SophonSnwflake/rocket-docs/docs/structures/totalstructure/index.md

# 箭体结构

记录火箭整体机械结构各部件的三维模型（STEP 格式），涵盖箭体、头锥、尾翼、发动机舱、航电舱、伞舱以及各连接环等部件。

## 部件 3D 模型（用于2026-10-3发射）

以下为各结构部件的三维模型文件，点击文件名即可下载：

| 部件 | 模型文件 |
|---|---|
| 箭体 | [箭体.step](assets/箭体.step)、[箭体 v3.step](assets/箭体%20v3.step) |
| 头锥 | [头锥111.step](assets/头锥111.step) |
| 尾翼 | [尾翼.step](assets/尾翼.step) |
| 发动机舱 | [发动机舱.step](assets/发动机舱.step) |
| 航电舱 | [航电舱.step](assets/航电舱.step) |
| 伞舱 | [伞舱.step](assets/伞舱.step) |
| 连接环 | [连接环.step](assets/连接环.step) |
| 中心环 | [中心环.step](assets/中心环.step) |
| 连接环_带螺丝孔_缩小长度 | [连接环.SLDPRT](assets/连接环带螺丝孔.SLDPRT) |
| 连接环_带螺丝孔_缩小长度 | [连接环.stl](assets/连接环缩短带螺丝.STL) |

## 部件 3D 模型

[燃料中心棒固定环文件](FuelFixRing/index.md)

## 说明

* 模型采用 STEP 格式（ISO 10303），适用于主流三维 CAD 软件（如 SolidWorks、Fusion 360、FreeCAD 等）。
* 各部件模型将随设计迭代持续更新。
