SophonSnwflake/rocket-docs/docs/propulsion/index.md

<figure markdown>
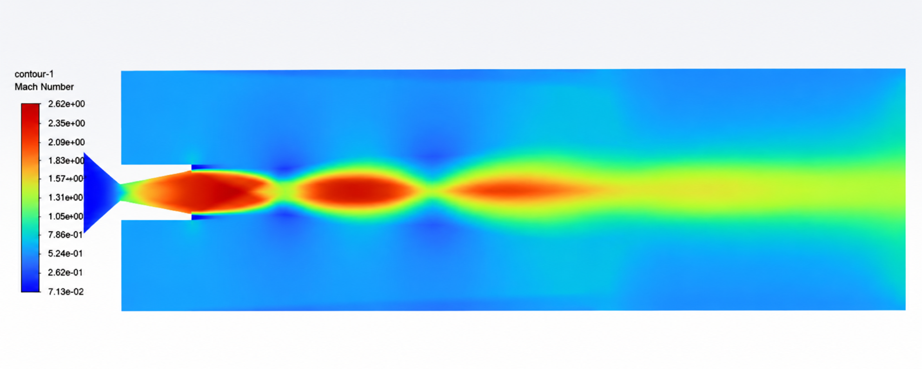
[picture p20: docs/propulsion/assets/picture/LOGO.png]
  
</figure>

# 推进系统

文档AI等级：4

推进系统是火箭产生推力并完成飞行任务的动力来源。

本板块用于记录火箭发动机设计、推进剂研究、发动机性能分析、静态测试、制造过程以及相关工程数据。

推进系统文档重点记录推进方案的设计依据、理论分析、实验数据以及实际工程经验，使后续开发人员能够理解发动机设计过程，而不仅仅获得最终参数。

---

## 系统概述

火箭推进系统主要负责：

- 产生满足飞行需求的推力
- 提供稳定可控的推力曲线
- 保证发动机结构安全
- 验证理论设计与实际性能之间的差异

推进系统通常由以下部分组成：

- 推进剂
- 燃烧室
- 喷管
- 点火系统
- 发动机壳体
- 保温与隔热结构
- 发动机与箭体连接结构

---

## 火箭燃料

固体火箭推进剂（燃料）的配方研究、制备工艺与性能测试相关资料。

| 板块 | 说明 | 文档 |
| -- | ---- | ---- |
| 火箭燃料 | 推进剂配方、原材料、制备工艺与测试资料 | [进入火箭燃料板块](fuel/index.md) |

---

## 发动机版本

| 版本 | 状态 | 简介 | 文档 |
| -- | ---- | ---- | ---- |
| V2 | 设计阶段 | 固体推进剂实验发动机，KNSB 推进剂，2026-07 开始设计 | [进入 V2 代发动机文档](v2/index.md) |

## 试车台

| 版本 | 状态 | 简介 | 文档 |
| -- | ---- | ---- | ---- |
| Oct 3 2026 | 正在使用 | 铝型材试车台，HX711, SD卡读取，串口控制 | [进入试车台文档](Oct_3_2026_TestMachine/index.md) |

> 上表中的版本状态应随着项目进展持续更新。

---
