SophonSnwflake/rocket-docs/docs/flight_records/index.md

# 飞行记录

飞行记录板块，用于记录火箭的实际飞行的相关文档

| 发射时间 | 飞控版本 | 简介 | 文档 |
| -- | ---- | ---- | ---- |
| Oct 3 2026 | V2.0 | 预计10.3发射于河南新乡 | [进入本次发射](Oct_3_2026/index.md) |
