SophonSnwflake/rocket-docs/docs/mad/index.md

<figure markdown>
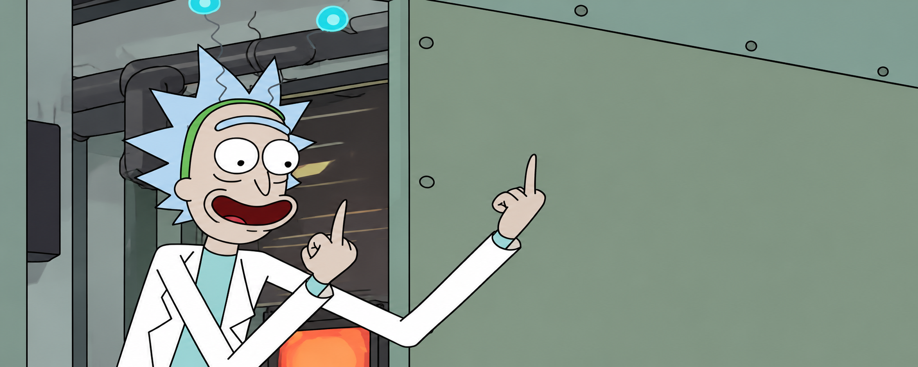
[picture p21: docs/mad/assets/picture/oldRick.png]
  
</figure>

# 发癫板块

本版块专门用于发癫、抽风和犯病，不设任何限制，可以说你任何想说的

### 8 Sep 2026 小叮当

没动力，不想推公式

### 14 Sep 2026 小叮当

我觉得工程和技术给人带来的应该是合作与共赢的文化，至少相较于零和竞争的商科是这样的。任何阻挠开放自由的环境并为此拉小圈子和小团体的人都是对开源文化的违背。

为何旧知己到最后变不成老友。

### 19 Sep 2026 小叮当

我觉得好累啊，这学期要做好多事，要完善航电，加新功能，期末均分要冲90，要参加科研进组，还要准备雅思。我觉得有点力不从心
