SophonSnwflake/rocket-docs/docs/development/index.md

# 开发规范（Development）

本区块用于记录一些团队开发过程中的开发规范文档

---

#### 文档工作流：[docsWorkflow](assets/docs_workflow.md)

#### 文档开发规范：[docsStandard](assets/docs_standard.md)
