SophonSnwflake/rocket-docs/docs/structures/avionics_bay/index.md

# 航电仓

| 版本 | 状态 | 简介 | 文档 |
| -- | ---- | --- | --- |
| V1 | 古早历史版本 | 2024年暑假搞的版本，适配性很差 | 无|
| V2 | 当前版本 | 当前主要开发与测试版本, 用于适配V2版本航电 | [进入 V2 文档](v2/index.md) |
