SophonSnwflake/rocket-docs/docs/avionics/v2/assets/hardware/BOM.xlsx

No. | Quantity | Comment | Designator | Footprint | Value | Manufacturer Part | Manufacturer | Supplier Part | Supplier
1 | 1 | 1uF | 1uF | C0603 | 1uF | CL10A105KO8NNNC | SAMSUNG(三星) | C1592 | LCSC
2 | 3 | 1.5kΩ | 1.5kΩ,1.5kΩ,1.5kΩ | R0603 | 1.5kΩ | FRC0603F1501TS | FOJAN(富捷) | C2930050 | LCSC
3 | 1 | 2.2uF | 2.2u | C0603 | 2.2uF | CL10A225KO8NNNC | SAMSUNG(三星) | C23630 | LCSC
4 | 1 | SI2301CDS-T1-GE3 | 3JG | SOT-23-3_L3.0-W1.7-P0.95-LS2.9-BR |  | SI2301CDS-T1-GE3 | VISHAY(威世) | C10487 | LCSC
5 | 2 | 4.7kΩ | 4.7k,4.7k | R0603 | 4.7kΩ | RCA034K7FLF | HKR(香港电阻) | C22369814 | LCSC
6 | 1 | 1kΩ | 10k | R0603 | 1kΩ | FRC0603F1001TS | FOJAN(富捷) | C2907002 | LCSC
7 | 10 | 10kΩ | 10k,10k,10k,10k,10k,10k,10k,10k,10kΩ,10kΩ | R0603 | 10kΩ | FRC0603F1002TS | FOJAN(富捷) | C2906982 | LCSC
8 | 1 | 10uF | 10u | C0603 | 10uF | HGC0603R5106M350NTHJ | Chinocera(华瓷) | C22367827 | LCSC
9 | 1 | 10uF | 10u | C0603 | 10uF | HGC0603R5106M160NTHJ | Chinocera(华瓷) | C7472959 | LCSC
10 | 2 | 10uF | 10u,10u | C0603 | 10uF | HGC0603R5106M250NTHJ | Chinocera(华瓷) | C7472961 | LCSC
11 | 2 | 16pF | 16pf,cristal_in | C0603 | 16pF | CC0603JRNPO9BN160 | YAGEO(国巨) | C327125 | LCSC
12 | 2 | 100kΩ | 100kΩ,100kΩ | R0603 | 100kΩ | FRC0603F1003TS | FOJAN(富捷) | C2906980 | LCSC
13 | 15 | 100nF | 100n,100n,100n,100n,100n,100n,100n,100n,100n,100n,100nF,100nf,VDD_1,VDD_2,VDD_3 | C0603 | 100nF | CL10B104KB8NNNC | SAMSUNG(三星) | C1591 | LCSC
14 | 2 | BLM18AG102SN1D | 500mΩ,imu_l | L0603 |  | BLM18AG102SN1D | muRata(村田) | C85824 | LCSC
15 | 2 | GH1.25mm-2P-LT | Battery,电子火柴 | CONN-SMD_2P-P1.25_THD1253-02WV-SN |  | GH1.25mm-2P-LT | LXWCONN(连兴旺电子) | C53055371 | LCSC
16 | 1 | BMI088 | BMI088 | LGA-16_L4.5-W3.0-P0.50-BL |  | BMI088 | Bosch(博世) | C194919 | LCSC
17 | 1 | BMP388 | BMP388 | SENSORM-SMD_BMP388 |  | BMP388 | Bosch(博世) | C779278 | LCSC
18 | 1 | 2.54-1*2 | BOOT | HDR-TH_2P-P2.54-V-M |  | 2.54-1*2 | ZHOURI(洲日) | C5116481 | LCSC
19 | 1 | 2.7kHz | BUZZER1 | BUZ-TH_BD12.0-P7.60-D0.6-FD | 2.7kHz | HMB1275-05B | 华能 | C96491 | LCSC
20 | 1 | S8050 | buzzer3jg | SOT-23-3_L2.9-W1.3-P1.90-LS2.3-BR |  | S8050 | R+O(宏嘉诚) | C20069125 | LCSC
21 | 1 | 100uF | C10 | C1206 | 100uF | HGC1206R5107M100NSPJ | Chinocera(华瓷) | C7432784 | LCSC
22 | 1 | W25Q128JVSIQ | Flash | SOIC-8_L5.3-W5.3-P1.27-LS8.0-BL |  | W25Q128JVSIQ | Winbond(华邦) | C97521 | LCSC
23 | 1 | WAFER-GH1.25-4PLB | GPS | CONN-SMD_4P-P1.25_XUNPU_WAFER-GH1.25-4PLB |  | WAFER-GH1.25-4PLB | XUNPU(讯普) | C3029370 | LCSC
24 | 2 | HX PZ2.54-1x4P ZZ | I2C,UART | HDR-TH_4P-P2.54-V-M |  | HX PZ2.54-1x4P ZZ | hanxia(韩下) | C32713270 | LCSC
25 | 1 | AO3400 | mos | SOT-23-3_L2.9-W1.3-P1.90-LS2.4-BR |  | AO3400 | Hottech(合科泰) | C181090 | LCSC
26 | 1 | 2.54-1*3P针 | PIN | HDR-TH_3P-P2.54-V-M-1 |  | 2.54-1*3P针 | BOOMELE(博穆精密) | C49257 | LCSC
27 | 1 | ME6217C33M5G | POWER | SOT-23-5_L3.0-W1.7-P0.95-LS2.8-BR |  | ME6217C33M5G | MICRONE(南京微盟) | C427602 | LCSC
28 | 1 | 6GHz | RF1 | SMA-TH_BWSMA-KE-Z001 | 6GHz | BWSMA-KE-Z001 | BAT WIRELESS(蝙蝠无线) | C496549 | LCSC
29 | 1 | PH2.54-1X5P-H25 | SWDIO | HDR-TH_5P-P2.54-V-M-3 |  | PH2.54-1X5P-H25 | JXTCONN(聚兴泰) | C42431835 | LCSC
30 | 1 | STM32F411CEU6TR | U2 | UFQFPN-48_L7.0-W7.0-P0.50-BL-EP5.6 |  | STM32F411CEU6TR | ST(意法半导体) | C2054095 | LCSC
31 | 1 | E22-400M22S | U7 | WIRELM-SMD_E22-400M22S |  | E22-400M22S | EBYTE(亿佰特) | C411291 | LCSC
32 | 1 | 25MHz | X1 | CRYSTAL-SMD_4P-L3.2-W2.5-BL | 25MHz | X322525MOB4SI | YXC(扬兴晶振) | C9006 | LCSC
33 | 1 | NCD0805Y1 | 危险状态指示 | LED0805-R-RD |  | NCD0805Y1 | 国星光电 | C84261 | LCSC
34 | 2 | PZ254V-11-02P | 点火安全保护,电源开关 | HDR-TH_2P-P2.54-V-M |  | PZ254V-11-02P | XFCN(兴飞) | C492401 | LCSC
35 | 1 | NCD0805R1 | 红 | LED0805-RD |  | NCD0805R1 | 国星光电 | C84256 | LCSC
36 | 1 | XL-2012UBC | 蓝 | LED0805-RD |  | XL-2012UBC | XINGLIGHT(成兴光) | C965817 | LCSC
