SophonSnwflake/rocket-docs/docs/propulsion/v2/assets/model/堵头.step

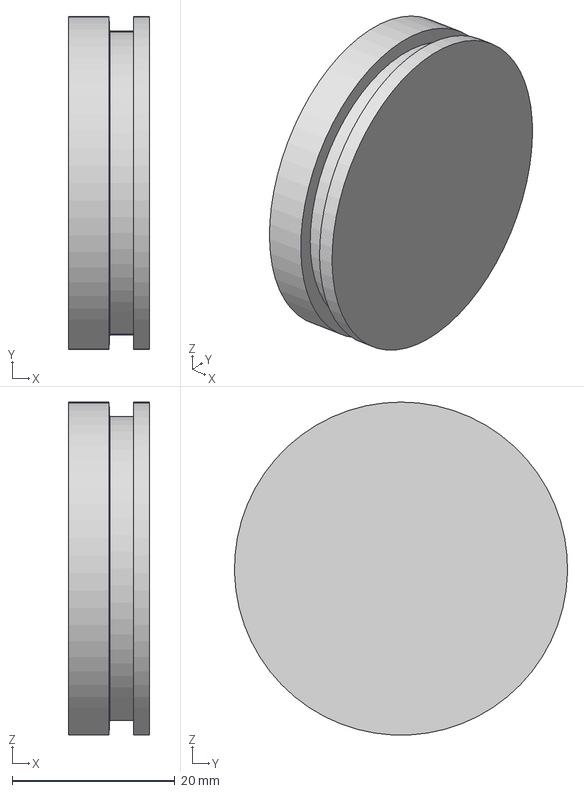
[picture p31: CAD file, 2026-08-23]
docs/propulsion/v2/assets/model/堵头.step
10.0 x 41.0 x 41.0 mm
