SophonSnwflake/rocket-docs/docs/structures/totalstructure/assets/连接环带螺丝孔.SLDPRT

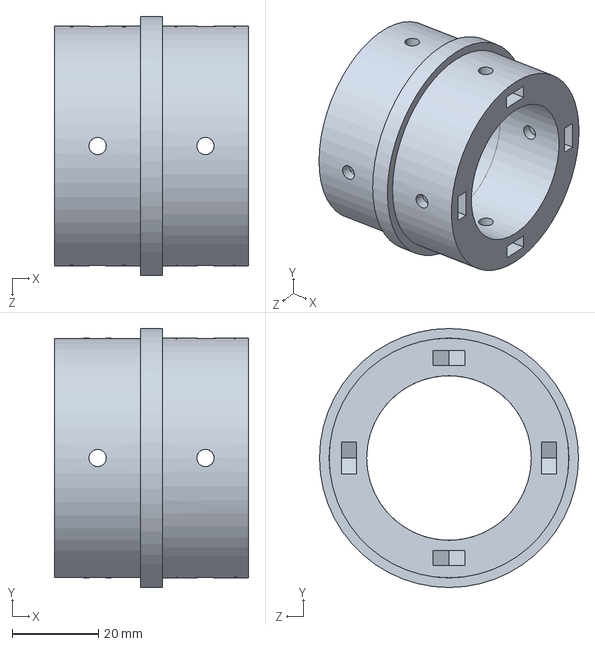
[picture p32: CAD file, 2026-09-23]
docs/structures/totalstructure/assets/连接环带螺丝孔.SLDPRT
45.0 x 60.0 x 60.0 mm
