SophonSnwflake/rocket-docs/docs/structures/totalstructure/FuelFixRing/assets/14mm.STL

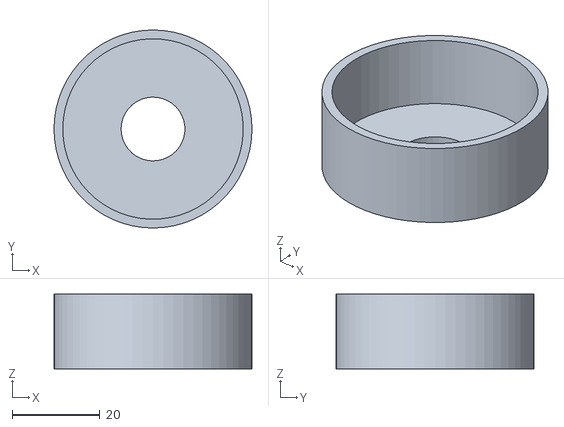
[picture p33: CAD file, 2026-09-30]
docs/structures/totalstructure/FuelFixRing/assets/14mm.STL
45.0 x 45.0 x 17.0
