SophonSnwflake/rocket-docs/docs/propulsion/v2/assets/model/喷口.step

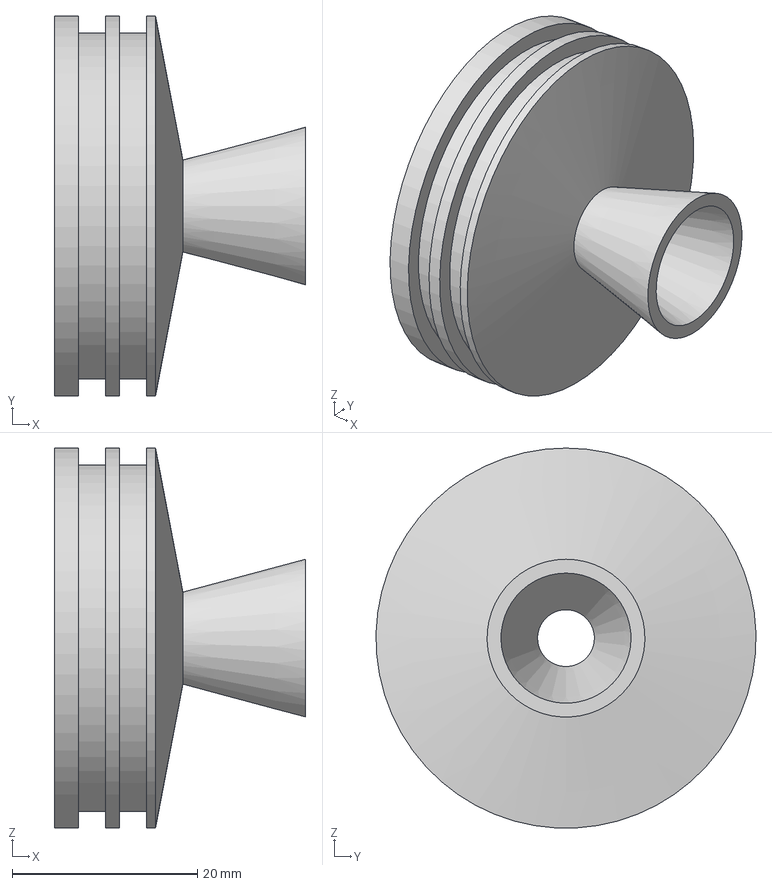
[picture p34: CAD file, 2026-08-23]
docs/propulsion/v2/assets/model/喷口.step
27.1 x 41.0 x 41.0 mm
