SophonSnwflake/rocket-docs/docs/structures/totalstructure/FuelFixRing/assets/22.STL

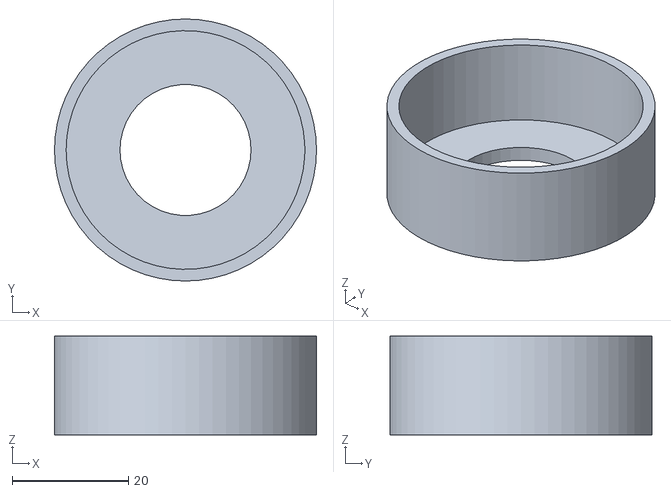
[picture p35: CAD file, 2026-09-30]
docs/structures/totalstructure/FuelFixRing/assets/22.STL
45.0 x 45.0 x 17.0
