SophonSnwflake/rocket-docs/docs/structures/totalstructure/assets/中心环.step

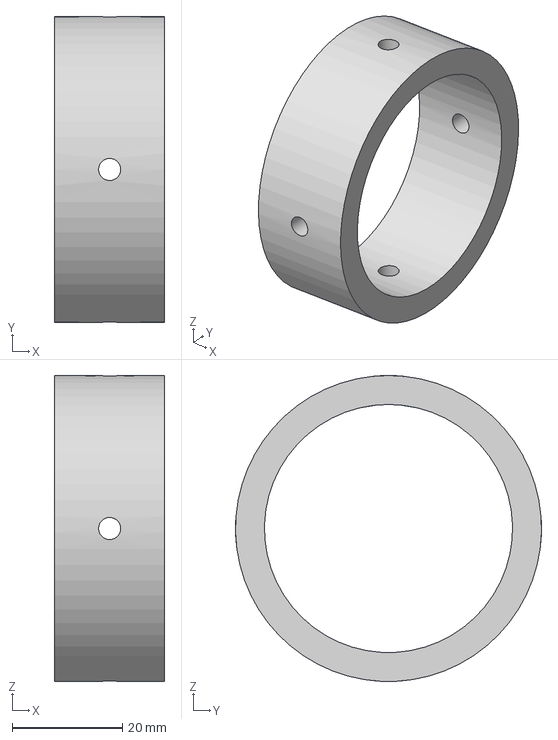
[picture p36: CAD file, 2026-08-23]
docs/structures/totalstructure/assets/中心环.step
20.0 x 55.5 x 55.5 mm
