SophonSnwflake/rocket-docs/docs/structures/totalstructure/FuelFixRing/assets/20mm.STL

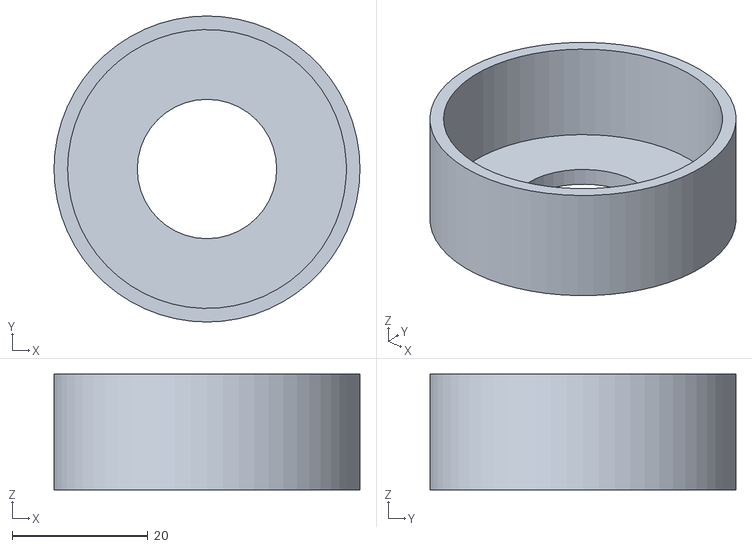
[picture p37: CAD file, 2026-09-30]
docs/structures/totalstructure/FuelFixRing/assets/20mm.STL
45.0 x 45.0 x 17.0
