SophonSnwflake/rocket-docs/docs/structures/totalstructure/assets/尾翼.step

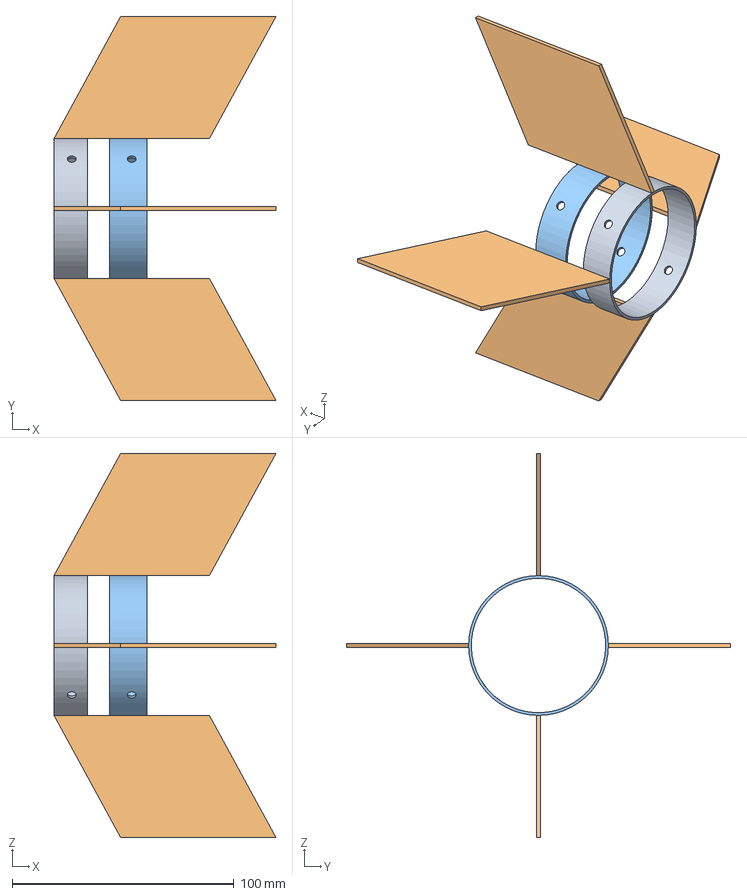
[picture p38: CAD file, 2026-08-23]
docs/structures/totalstructure/assets/尾翼.step
100.0 x 173.0 x 173.0 mm
