SophonSnwflake/rocket-docs/docs/structures/totalstructure/assets/伞舱.step

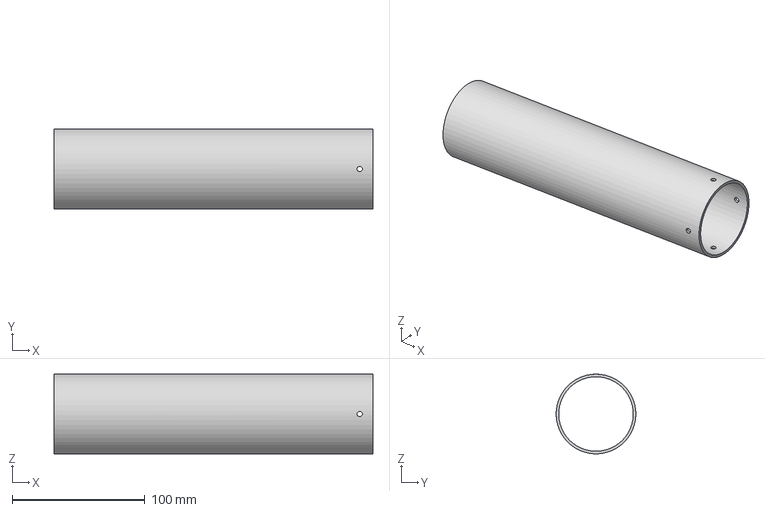
[picture p40: CAD file, 2026-08-23]
docs/structures/totalstructure/assets/伞舱.step
240.0 x 60.0 x 60.0 mm
