SophonSnwflake/rocket-docs/docs/structures/totalstructure/assets/箭体.step

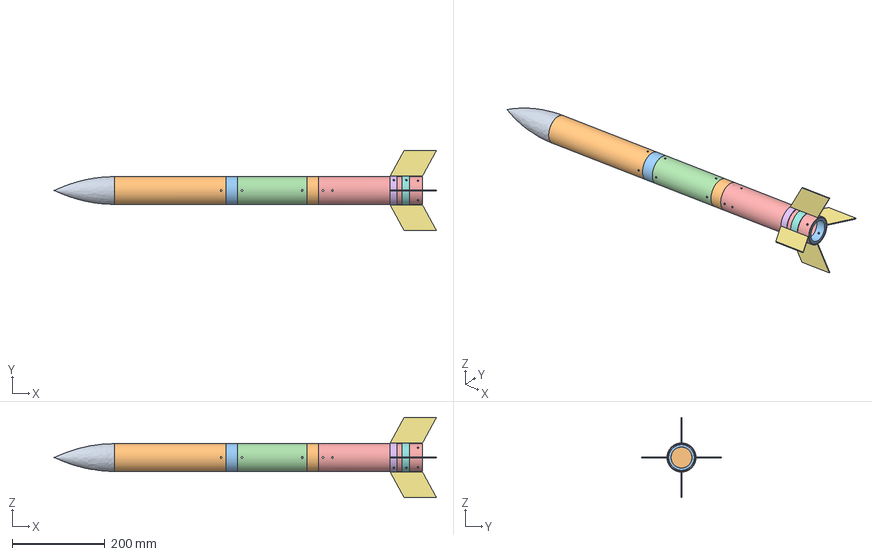
[picture p41: CAD file, 2026-08-23]
docs/structures/totalstructure/assets/箭体.step
825.0 x 173.0 x 173.0 mm
零部件1
零部件2
零部件3
零部件4
零部件5
零部件6
零部件7
