SophonSnwflake/rocket-docs/docs/structures/totalstructure/assets/发动机舱.step

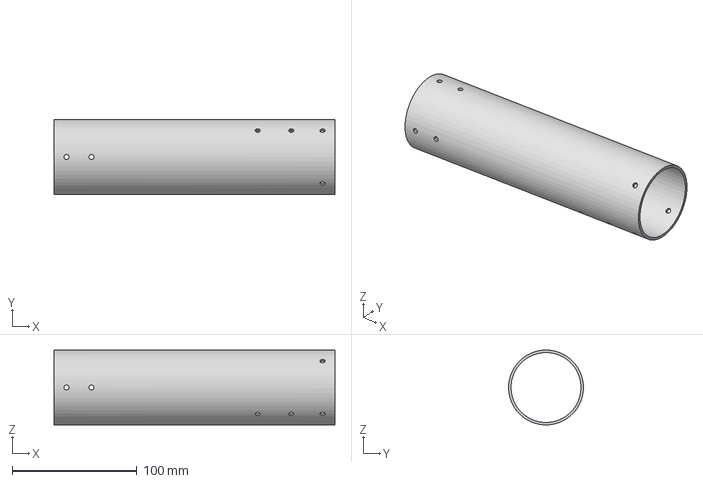
[picture p42: CAD file, 2026-08-23]
docs/structures/totalstructure/assets/发动机舱.step
225.0 x 60.0 x 60.0 mm
