SophonSnwflake/rocket-docs/docs/structures/totalstructure/assets/连接环.step

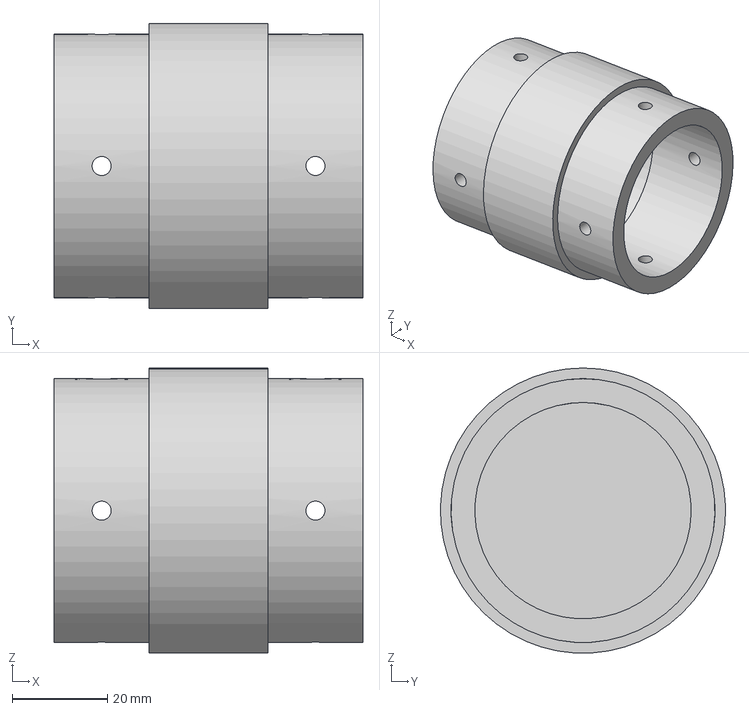
[picture p43: CAD file, 2026-08-23]
docs/structures/totalstructure/assets/连接环.step
65.0 x 60.0 x 59.9 mm
