SophonSnwflake/rocket-docs/docs/structures/totalstructure/assets/头锥111.step

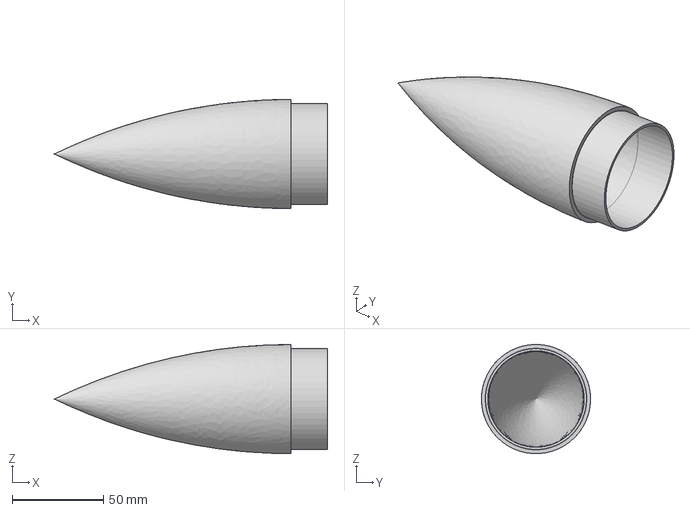
[picture p44: CAD file, 2026-08-23]
docs/structures/totalstructure/assets/头锥111.step
150.0 x 60.0 x 59.9 mm
