SophonSnwflake/rocket-docs/docs/structures/totalstructure/assets/航电舱.step

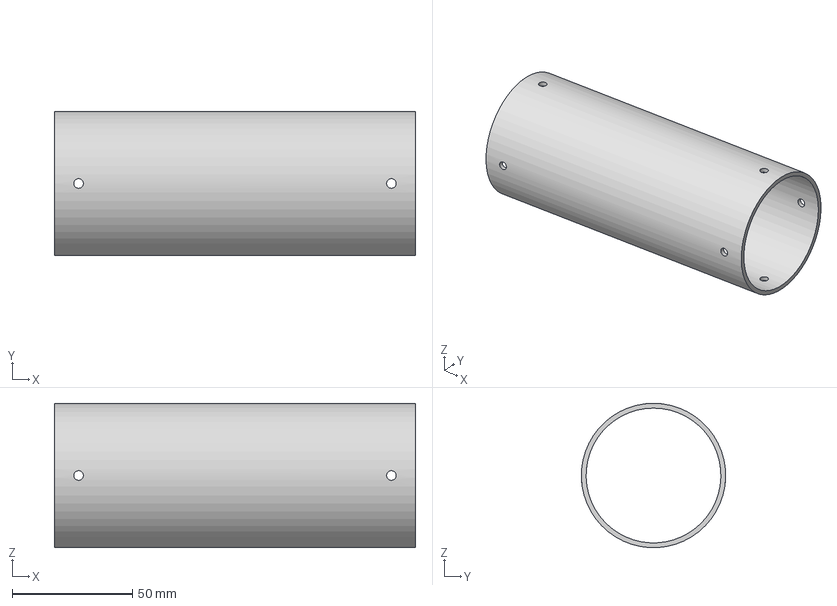
[picture p45: CAD file, 2026-08-23]
docs/structures/totalstructure/assets/航电舱.step
150.0 x 60.0 x 60.0 mm
