SophonSnwflake/rocket-docs/(list of files, cad)

Other CAD files:
docs/structures/totalstructure/assets/连接环缩短带螺丝.STL
docs/structures/totalstructure/assets/箭体 v3.step
