SophonSnwflake/rocket-docs/docs/propulsion/Oct_3_2026_TestMachine/index.md

# Oct_3_2026 试车台

本次试车台用于试验在2026年10月3日河南新乡所用火箭的发动机。

## 设计者：白

## 硬件设计：

- Arduino uno
- HX711-UART模块
- SD卡槽-UART模块
- 串口通信

## 软件版本（arduino）

| 序列 | 简介 | 源码 |
| -- | ---- | ---- |
| 1.2 | 10.1日试车采用的版本，遇到SD卡失联后会中断 | [下载源码](assets/thrust_capture_80hz_1.2.ino) |
| 1.3 | 更新了串口输出完整时间戳和推力数据，并且不会随着SD卡的失联而断掉串口 | [下载源码](assets//thrust_capture_80hz_1.3.ino) |
