SophonSnwflake/rocket-docs/docs/structures/totalstructure/FuelFixRing/index.md

### 燃料固定环3D模型

| 部件 | 模型文件 |
|---|---|
| 1 | [14mm.STL](assets/14mm.STL)|
| 2 | [20mm.STL](assets/20mm.STL) |
| 3 | [22mm.STL](assets/22.STL) |
| 4 | [25mm.STL](assets/25mm.STL) |
