SophonSnwflake/rocket-docs/docs/avionics/v2/assets/hardware/PCB图.pdf

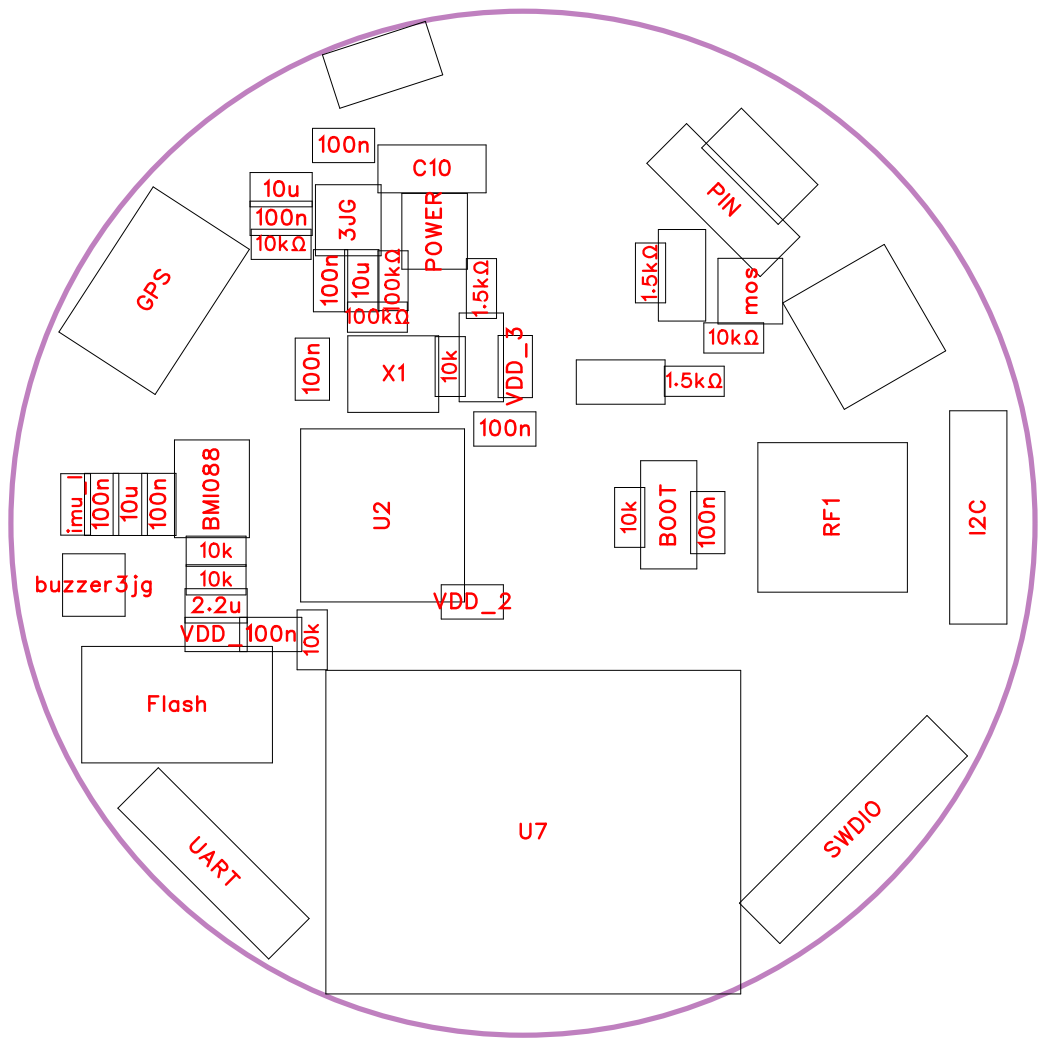
[picture p46: page 1]

VDD_1 | 100n

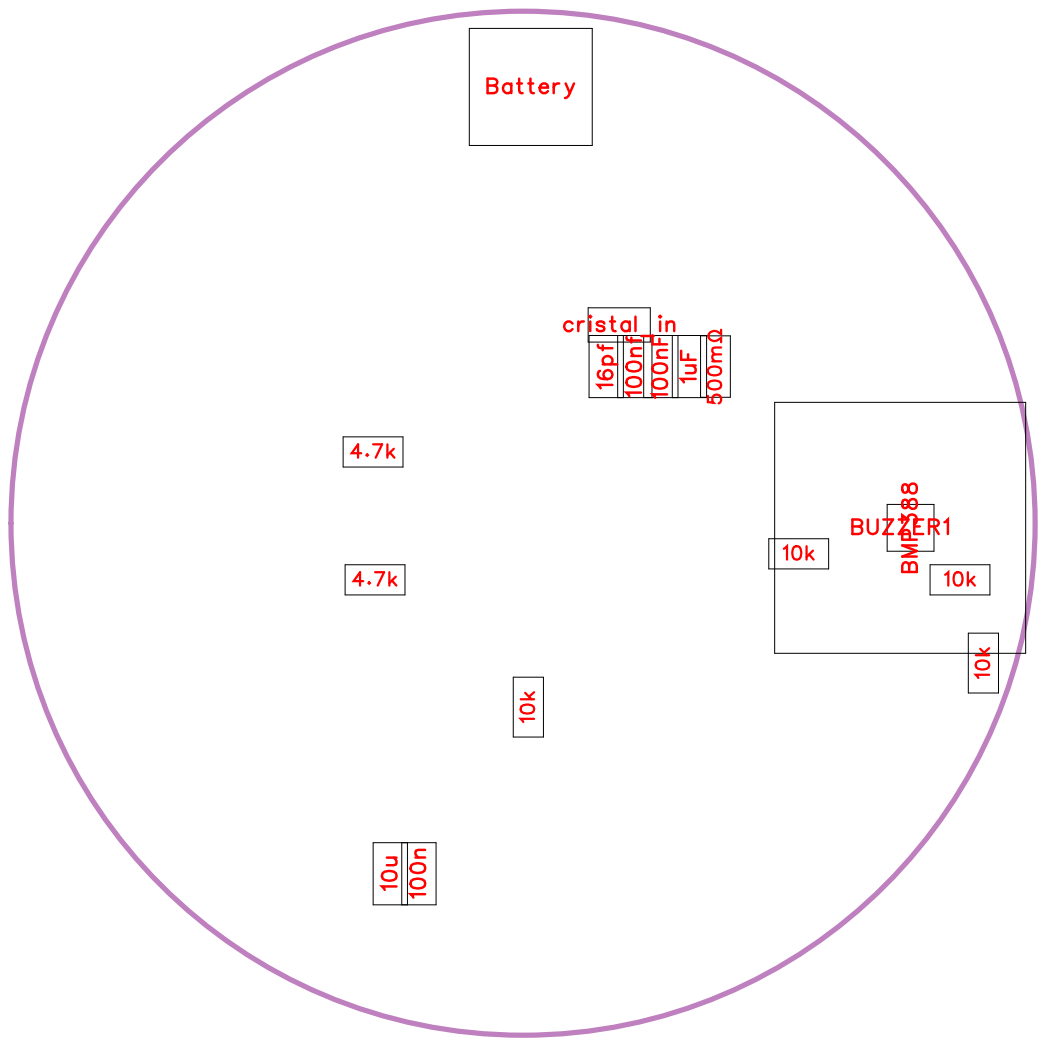
[picture p47: page 2]

No. | Quantity | Comment | Designator | Footprint | Value | Manufacturer Part | Manufacturer | Supplier Part | Supplier
1 | 1 | 1uF | 1uF | C0603 | 1uF | CL10A105K O8NNNC | SAMSUNG( 三星) | C1592 | LCSC
2 | 3 | 1.5k | 1.5k ,1.5k ,1.5k | R0603 | 1.5k | FRC0603F15 01TS | FOJAN(富捷) | C2930050 | LCSC
3 | 1 | 2.2uF | 2.2u | C0603 | 2.2uF | CL10A225K O8NNNC | SAMSUNG( 三星) | C23630 | LCSC
4 | 1 | SI2301CDS-T1-GE3 | 3JG | SOT-23-3_L3 .0-W1.7-P0.9 5-LS2.9-BR | | SI2301CDS-T1-GE3 | VISHAY(威世 ) | C10487 | LCSC
5 | 2 | 4.7k | 4.7k,4.7k | R0603 | 4.7k | RCA034K7F LF | HKR(香港电 阻) | C22369814 | LCSC
6 | 1 | 1k | 10k | R0603 | 1k | FRC0603F10 01TS | FOJAN(富捷) | C2907002 | LCSC
7 | 10 | 10k | 10k,10k,10k,10k,10k,10k,10 k,10k,10k ,10k | R0603 | 10k | FRC0603F10 02TS | FOJAN(富捷) | C2906982 | LCSC
8 | 1 | 10uF | 10u | C0603 | 10uF | HGC0603R5 106M350NT HJ | Chinocera(华 瓷) | C22367827 | LCSC
9 | 1 | 10uF | 10u | C0603 | 10uF | HGC0603R5 106M160NT HJ | Chinocera(华 瓷) | C7472959 | LCSC
10 | 2 | 10uF | 10u,10u | C0603 | 10uF | HGC0603R5 106M250NT HJ | Chinocera(华 瓷) | C7472961 | LCSC
11 | 2 | 16pF | 16pf,cristal_in | C0603 | 16pF | CC0603JRN PO9BN160 | YAGEO(国巨 ) | C327125 | LCSC
12 | 2 | 100k | 100k ,100k | R0603 | 100k | FRC0603F10 03TS | FOJAN(富捷) | C2906980 | LCSC
13 | 15 | 100nF | 100n,100n,100n,100n,100n, 100n,100n,100n,100n,100n, 100nF,100nf,VDD_1,VDD_2 ,VDD_3 | C0603 | 100nF | CL10B104KB 8NNNC | SAMSUNG( 三星) | C1591 | LCSC
14 | 2 | BLM18AG10 2SN1D | 500m ,imu_l | L0603 | | BLM18AG10 2SN1D | muRata(村田 ) | C85824 | LCSC
15 | 2 | GH1.25mm-2 P-LT | Battery,电子火柴 | CONN-SMD_ 2P-P1.25_TH D1253-02WV -SN | | GH1.25mm-2 P-LT | LXWCONN( 连兴旺电子) | C53055371 | LCSC
16 | 1 | BMI088 | BMI088 | LGA-16_L4.5 -W3.0-P0.50-BL | | BMI088 | Bosch(博世) | C194919 | LCSC
17 | 1 | BMP388 | BMP388 | SENSORM-S MD_BMP388 | | BMP388 | Bosch(博世) | C779278 | LCSC
18 | 1 | 2.54-1*2 | BOOT | HDR-TH_2P-P2.54-V-M | | 2.54-1*2 | ZHOURI(洲 日) | C5116481 | LCSC
19 | 1 | 2.7kHz | BUZZER1 | BUZ-TH_BD 12.0-P7.60-D 0.6-FD | 2.7kHz | HMB1275-05 B | 华能 | C96491 | LCSC

20 | 1 | S8050 | buzzer3jg | SOT-23-3_L2 .9-W1.3-P1.9 0-LS2.3-BR | | S8050 | R+O(宏嘉诚 ) | C20069125 | LCSC
21 | 1 | 100uF | C10 | C1206 | 100uF | HGC1206R5 107M100NS PJ | Chinocera( 华 瓷 ) | C7432784 | LCSC
22 | 1 | W25Q128JV SIQ | Flash | SOIC-8_L5.3 -W5.3-P1.27-LS8.0-BL | | W25Q128JV SIQ | Winbond( 华 ) 邦 | C97521 | LCSC
23 | 1 | WAFER-GH1 .25-4PLB | GPS | CONN-SMD_ 4P-P1.25_X UNPU_WAF ER-GH1.25-4 PLB | | WAFER-GH1 .25-4PLB | XUNPU(讯普 ) | C3029370 | LCSC
24 | 2 | HX PZ2.54-1x4P ZZ | I2C,UART | HDR-TH_4P-P2.54-V-M | | HX PZ2.54-1x4P ZZ | hanxia(韩下 ) | C32713270 | LCSC
25 | 1 | AO3400 | mos | SOT-23-3_L2 .9-W1.3-P1.9 0-LS2.4-BR | | AO3400 | Hottech(合科 泰) | C181090 | LCSC
26 | 1 | 2.54-1*3P 针 | PIN | HDR-TH_3P-P2.54-V-M-1 | | 2.54-1*3P 针 | BOOMELE( ) 博穆精密 | C49257 | LCSC
27 | 1 | ME6217C33 M5G | POWER | SOT-23-5_L3 .0-W1.7-P0.9 5-LS2.8-BR | | ME6217C33 M5G | MICRONE( 南 ) 京微盟 | C427602 | LCSC
28 | 1 | 6GHz | RF1 | SMA-TH_BW SMA-KE-Z00 1 | 6GHz | BWSMA-KE-Z001 | BAT WIRELE SS(蝙蝠无线 ) | C496549 | LCSC
29 | 1 | PH2.54-1X5 P-H25 | SWDIO | HDR-TH_5P-P2.54-V-M-3 | | PH2.54-1X5 P-H25 | JXTCONN( 聚 兴泰 ) | C42431835 | LCSC
30 | 1 | STM32F411 CEU6TR | U2 | UFQFPN-48 _L7.0-W7.0-P0.50-BL-EP 5.6 | | STM32F411 CEU6TR | ST(意法半导 体) | C2054095 | LCSC
31 | 1 | E22-400M22 S | U7 | WIRELM-SM D_E22-400M 22S | | E22-400M22 S | EBYTE(亿佰 特) | C411291 | LCSC
32 | 1 | 25MHz | X1 | CRYSTAL-S MD_4P-L3.2-W2.5-BL | 25MHz | X322525MO B4SI | YXC(扬兴晶 振) | C9006 | LCSC
33 | 1 | NCD0805Y1 | 危险状态指示 | LED0805-R-RD | | NCD0805Y1 | 国星光电 | C84261 | LCSC
34 | 2 | PZ254V-11-0 2P | ,电源开关 点火安全保护 | HDR-TH_2P-P2.54-V-M | | PZ254V-11-0 2P | XFCN(兴飞 ) | C492401 | LCSC
35 | 1 | NCD0805R1 | 红 | LED0805-RD | | NCD0805R1 | 国星光电 | C84256 | LCSC
36 | 1 | XL-2012UBC | 蓝 | LED0805-RD | | XL-2012UBC | XINGLIGHT( 成兴光 ) | C965817 | LCSC

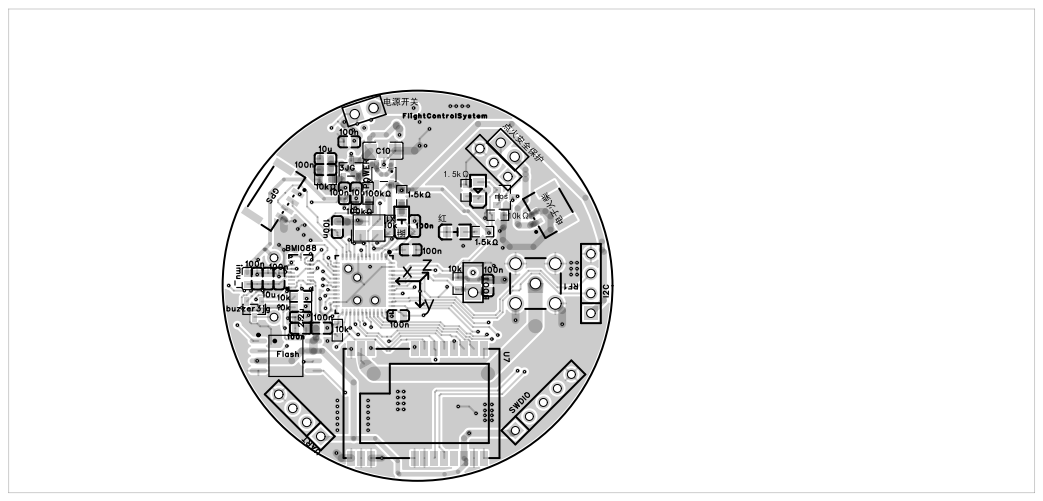
[picture p48: page 5]

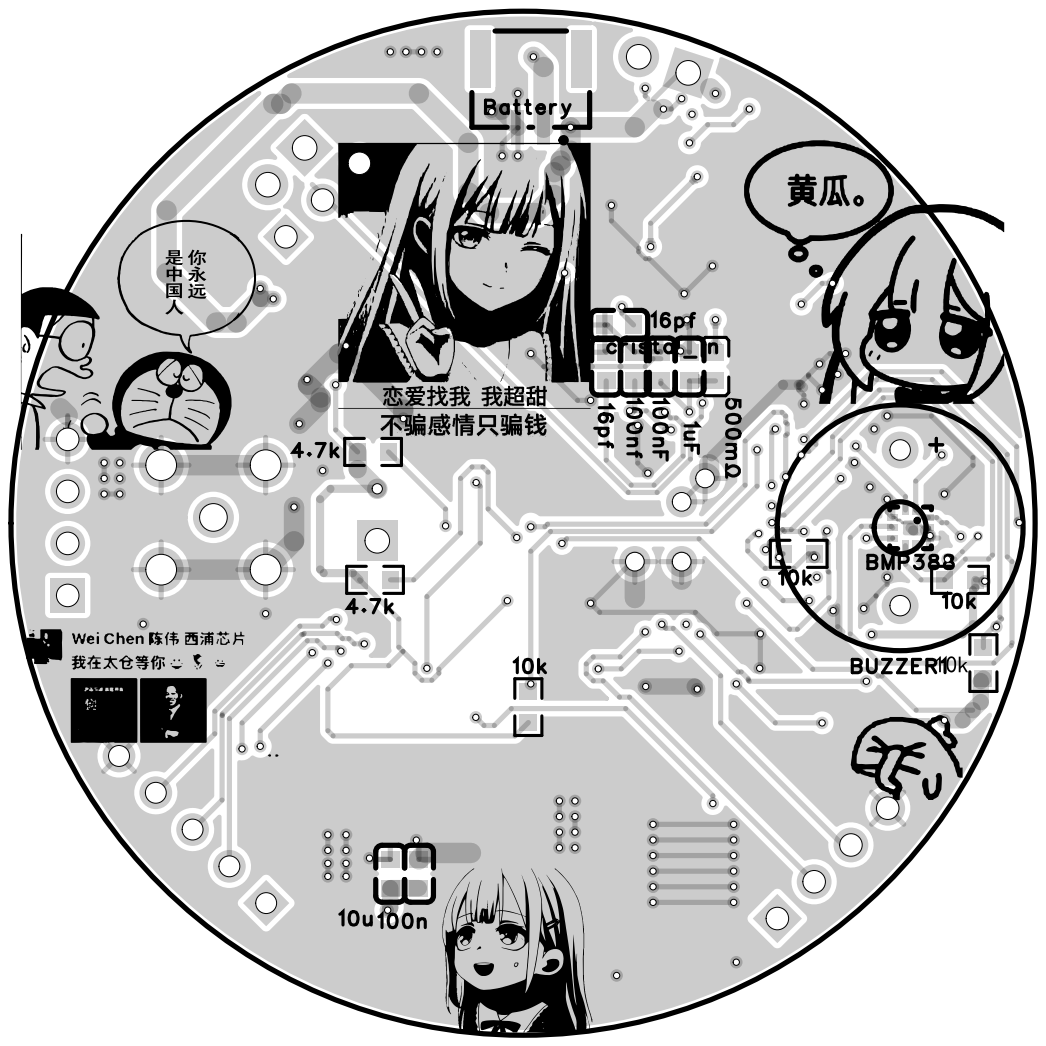
[picture p49: page 6]

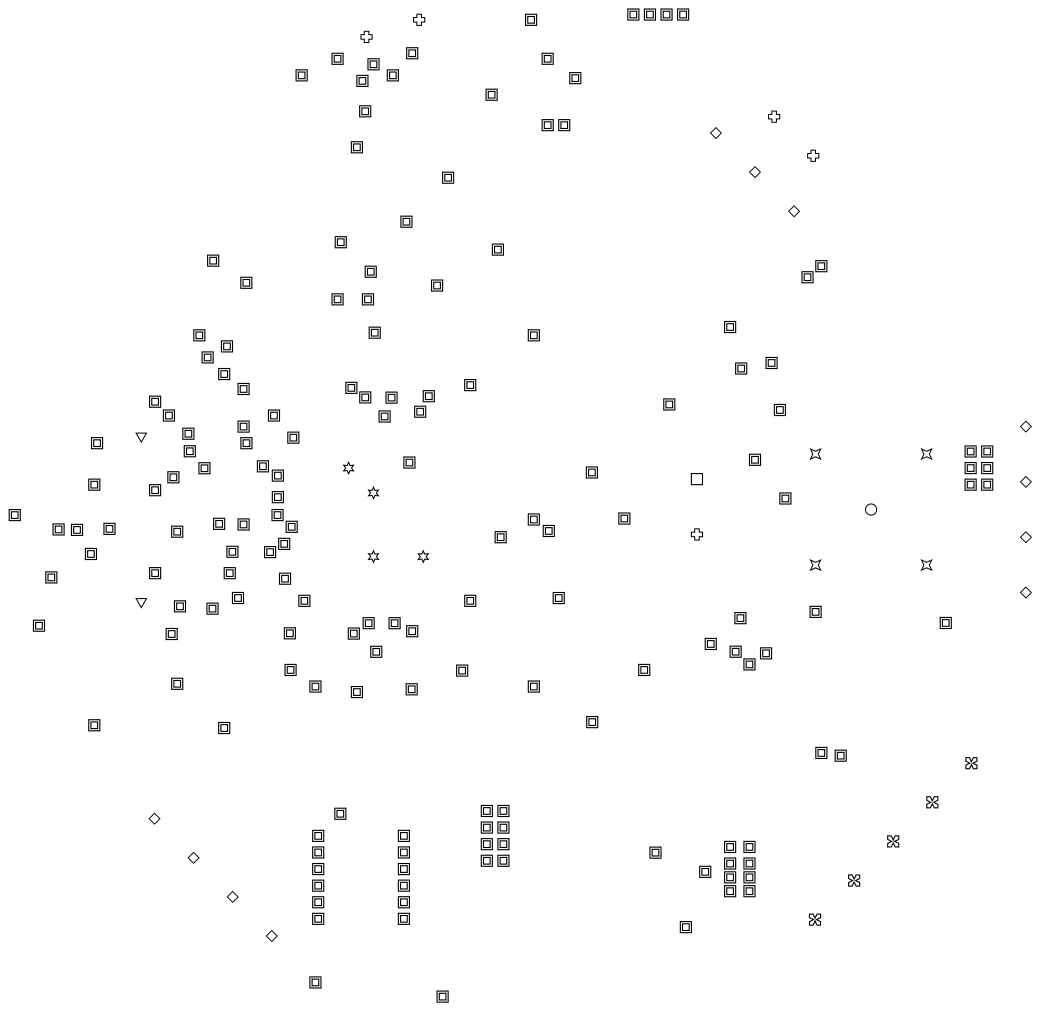
[picture p50: page 7]
