SophonSnwflake/rocket-docs/(commit log)

2026-08-20 配置 MkDocs 自动部署
2026-08-20 自定义域名
2026-08-20 添加航电系统文档
    [BOM.xlsx, PickAndPlace.xlsx]
2026-08-20 更改development文件夹的结构
2026-08-20 Add avionics bay CAD files using LFS
2026-08-20 重定向一个文件
2026-08-20 添加发癫板块
2026-08-21 改一些logo
2026-08-22 加入航电V2的细节说明
2026-08-22 加入详细双Commander设计说明
2026-08-23 增添火箭部件的3D文档
    [中心环.step, 伞舱.step, 发动机舱.step, 头锥111.step, 尾翼.step, 箭体 v3.step, 箭体.step, 航电舱.step]
2026-08-23 Revert "增添火箭部件的3D文档"
    [中心环.step, 伞舱.step, 发动机舱.step, 头锥111.step, 尾翼.step, 箭体 v3.step, 箭体.step, 航电舱.step]
2026-08-23 增添火箭部件3D文档至舰体结构板块
    [中心环.step, 伞舱.step, 发动机舱.step, 头锥111.step, 尾翼.step, 箭体 v3.step, 箭体.step, 航电舱.step]
2026-08-23 增添推进系统2代发动机资料 (#4)
    * 增添推进系统2代发动机资料至推进系统板块
    * 增添推进系统试车视频资料至V2发动机板块
    * 按开发规范将推进系统试车视频文件名改为英文
    * 按开发规范将推进系统照片改为英文名并在网页内嵌展示
    [喷口.step, 堵头.step]
2026-08-23 格式小修改
2026-08-23 删掉两个没有定义的版块
2026-08-24 新增火箭燃料板块 (#5)
2026-08-24 修改推进系统板块的一个字体格式化小bug
2026-09-01 增加V2航电debug记录
2026-09-01 修改一个格式小bug
2026-09-08 添加一个Debug记录
2026-09-14 更新Debug记录
2026-09-14 更改一个命名不妥
2026-09-14 修改Windows导致的git未跟踪
2026-09-17 增加debug记录
2026-09-17 修复小错误
2026-09-18 增加航电的一个日志
2026-09-18 加入新日志
2026-09-19 更新双Commander警告
2026-09-19 更新日志
2026-09-20 添加一个芯片手册
2026-09-21 重构V2航电文档结构，更新日志
2026-09-23 增加改进版连接环3D模型
    [连接环带螺丝孔.SLDPRT, 连接环缩短带螺丝.STL]
2026-09-30 增加若干燃料固定环3D文件 (#6)
    [14mm.STL, 20mm.STL, 22.STL, 25mm.STL]
2026-09-30 添加发射日志
2026-09-30 修复一个bug
2026-09-30 更新操作手册
2026-10-01 测试修改README文档 (#7)
2026-10-01 更新发射流程手册，删除奇怪的README
2026-10-01 增加10月1日日志
    [Oct12026试车原始数据（无补全）.CSV]
2026-10-01 增加换行
2026-10-01 增加试车台信息
2026-10-05 初步加入Oct_3的所有发射日志
    [Oct_2推力数据_22mm.xlsx]
2026-10-05 修改部分日志
2026-10-18 修正小错误
2026-11-02 加入复盘分析
2026-11-02 删掉英语语言包
